UPennRocketry/flightcomputerv1/flightcomputerv1bomREPLY.xls

PCBWay Bom Quotation, Product No.:T-X6W971159A
Item # | *Designator | *Qty | Manufacturer | *Mfg Part # | Description / Value | *Package/Footprint | Mounting Type | Your Instructions / Notes | Assembly requirement | *Unit Price(1 set) | *Total | *Delivery Time | *PCBWay Note | Customer Reply | PCBWay Update
1 | BZ1 | 1 | PUI Audio | AT-0927-TT-6-R | Buzzer『 』Buzzer, polarized | MagneticBuzzer_PUI_AT-0927-TT-6-R『 』THT | tht |  |  | $0.677 | $0.677 | 7-10Workdays
2 | C1, C4, C5 | 3 | Samsung Electro-Mechanics | CL10B104KA8NNNC | 0.1uF『 』Unpolarized capacitor, <10% tolerance | C_0201_0603Metric_Pad0.64x0.40mm_HandSolder『 』0603 | smt | generic |  | $0.050 | $0.150 |  | The correct package for the listed Part Number [CL10B104KA8NNNC] is indeed [0603], not [0201].Please confirm. | Yes, 0603 package please
3 | C10, C3, C7, C8 | 4 | Samsung Electro-Mechanics | CL10A106KQ8NNNC | 10uF『 』Unpolarized capacitor, <10% tolerance | C_0201_0603Metric_Pad0.64x0.40mm_HandSolder『 』0603 | smt | generic |  | $0.050 | $0.200 |  | The correct package for the listed Part Number [CL10A106KQ8NNNC] is indeed [0603（1608 metric）], not [0201].Please confirm. | Yes, 0603 package please
4 | C2 | 1 | Samsung Electro-Mechanics | CL10B105KP8NNNC | 1uF『 』Unpolarized capacitor, <10% tolerance | C_0201_0603Metric_Pad0.64x0.40mm_HandSolder『 』0603 | smt | generic |  | $0.050 | $0.050 |  | The correct package for the listed Part Number [CL10B105KP8NNNC] is indeed [0603（1608 metric）], not [0201].Please confirm. | Yes, 0603 package please
5 | C6 | 1 | Samsung Electro-Mechanics | CL10B104KA8NNNC | 100nF『 』Unpolarized capacitor, <10% tolerance | C_0201_0603Metric_Pad0.64x0.40mm_HandSolder『 』0603 | smt | generic |  | $0.050 | $0.050 |  | The correct package for the listed Part Number [CL10B104KA8NNNC] is indeed [0603], not [0201].Please confirm. | Yes, 0603 package please
6 | C9 | 1 | Samsung Electro-Mechanics | CL10A226MP8NUNE | 22uF『 』Unpolarized capacitor, <10% tolerance | C_0201_0603Metric_Pad0.64x0.40mm_HandSolder『 』0603 | smt | generic |  | $0.050 | $0.050 |  | The correct package for the listed Part Number [CL10A226MP8NUNE] is indeed [0603（1608 metric）], not [0201].Please confirm. | Yes, 0603 package please
7 | D1 | 1 | Würth Elektronik | 150060RS75000 | LED『 』Light emitting diode, RED | LED_0603_1608Metric_Pad1.05x0.95mm_HandSolder『 』0603 | smt | generic |  | $0.374 | $0.374 | 7-10 Workdays
8 | D2 | 1 | Würth Elektronik | 150060YS75000 | LED『 』Light emitting diode, YELLOW | LED_0603_1608Metric_Pad1.05x0.95mm_HandSolder『 』0603 | smt | generic |  | $0.374 | $0.374 | 7-10 Workdays
9 | D3 | 1 | Würth Elektronik | 150060GS75000 | LED『 』Light emitting diode, GREEN | LED_0603_1608Metric_Pad1.05x0.95mm_HandSolder『 』0603 | smt | generic |  | $0.374 | $0.374 | 7-10 Workdays
10 | IC1 | 1 | MEMSIC | MMC5983MA | MMC5983MA『 』3-AXIS MAGNETIC SENSOR | MMC5983MA_MEM『 』16-VFLGA | smt |  |  | $2.013 | $2.013
11 | J1, J2 | 2 | TE Connectivity AMP Connectors | 282834-2 | Screw_Terminal_01x02『 』TERM BLK 2P SIDE ENT 2.54MM PCB | TerminalBlock_TE_282834-2_1x02_P2.54mm_Horizontal『 』THT | tht | Ensure screw terminals facing out of board |  | $1.238 | $2.476 | 7-10Workdays
12 | J10 | 1 |  |  | Conn_01x01『 』Generic connector, single row, 01x01, script generated (kicad-library-utils/schlib/autogen/connector/) | PinHeader_1x01_P2.54mm_Vertical『 』THT | tht |  | DNP |  |  |  | [DNP不要贴];
13 | J11 | 1 |  |  | Conn_01x01『 』Generic connector, single row, 01x01, script generated (kicad-library-utils/schlib/autogen/connector/) | PinHeader_1x01_P2.54mm_Vertical『 』THT | tht |  | DNP |  |  |  | [DNP不要贴];
14 | J3 | 1 |  |  | Conn_01x03『 』Generic connector, single row, 01x03, script generated (kicad-library-utils/schlib/autogen/connector/) | PinHeader_1x03_P2.54mm_Vertical『 』THT | tht |  | DNP |  |  |  | [DNP不要贴];
15 | J4 | 1 |  |  | Conn_01x03『 』Generic connector, single row, 01x03, script generated (kicad-library-utils/schlib/autogen/connector/) | PinHeader_1x03_P2.54mm_Vertical『 』THT | tht |  | DNP |  |  |  | [DNP不要贴];
16 | J5 | 1 | JST Sales America Inc. | S2B-PH-K-S | Conn_01x02『 』CONN HEADER R/A 2POS 2MM | JST_PH_S2B-PH-K_1x02_P2.00mm_Horizontal『 』THT | tht |  |  | $0.828 | $0.828 | 7-10 Workdays
17 | J6 | 1 |  |  | Conn_01x24『 』Generic connector, single row, 01x24, script generated (kicad-library-utils/schlib/autogen/connector/) | Molex_SL_171971-0024_1x24_P2.54mm_Vertical『 』THT | tht |  | DNP |  |  |  | [DNP不要贴];
18 | J7 | 1 |  |  | Conn_01x24『 』Generic connector, single row, 01x24, script generated (kicad-library-utils/schlib/autogen/connector/) | Molex_SL_171971-0024_1x24_P2.54mm_Vertical『 』THT | tht |  | DNP |  |  |  | [DNP不要贴];
19 | J8, J9 | 2 | Amphenol RF | 132134 | Conn_Coaxial『 』CONN SMA JACK STR 50 OHM PCB | SMA_Amphenol_132134-10_Vertical『 』SMA | smt |  |  | $4.541 | $9.082
20 | J12, J13 | 2 | Molex | 734120110 | Conn_Coaxial『 』U.FL (UMCC) Connector Receptacle, Male Pin 50 Ohms Surface Mount Solder | U.FL_Molex_MCRF_73412-0110_Vertical『 』U.FL | smt |  |  | $0.747 | $1.494
21 | M1, M2 | 2 | Harwin Inc. | M20-9990345 | Motor_Servo『 』Servo Motor (Futaba, HiTec, JR connector) | PinHeader_1x03_P2.54mm_Vertical『 』THT | tht |  |  | $0.634 | $1.268 | 7-10 Workdays
22 | Q1 | 1 | Vishay Siliconix | SI4925DDY-T1-GE3 | SI4925DDY-T1-GE3『 』Vishay SI4925DDY-T1-GE3 Dual P-channel MOSFET Transistor, 8 A, 30 V, 8-Pin SOIC | SOIC127P600X175-8N『 』8-SOIC (0.154, 3.90mm Width) | smt |  |  | $2.367 | $2.367
23 | Q2 | 1 | onsemi | MMBT3904LT3G | MMBT3904『 』0.2A Ic, 40V Vce, Small Signal NPN Transistor, SOT-23 | SOT-23『 』SOT-23-3 (TO-236) | smt |  |  | $0.664 | $0.664
24 | Q3 | 1 | onsemi | MMBT3904LT3G | MMBT3904『 』0.2A Ic, 40V Vce, Small Signal NPN Transistor, SOT-23 | SOT-23『 』SOT-23-3 (TO-236) | smt |  |  | $0.664 | $0.664
25 | R1, R3 | 2 | Panasonic Electronic Components | ERJ-3GEYJ103V | 10K『 』Resistor, <10% tolerance | R_0201_0603Metric_Pad0.64x0.40mm_HandSolder『 』0603 | smt | generic |  | $0.046 | $0.092 |  | The correct package for the listed Part Number [ERJ-3GEYJ103V] is indeed [0603], not [0201].Please confirm. | Yes, 0603 package please
26 | R10, R11, R9 | 3 | Panasonic Electronic Components | ERJ-3EKF1500V | 150『 』Resistor, <10% tolerance | R_0201_0603Metric_Pad0.64x0.40mm_HandSolder『 』0603 | smt | generic |  | $0.046 | $0.138 |  | The correct package for the listed Part Number [ERJ-3EKF1500V] is indeed [0603], not [0201].Please confirm. | Yes, 0603 package please
27 | R14 | 1 | Panasonic Electronic Components | ERA-3AEB122V | 1.2k『 』Resistor, <10% tolerance | R_0201_0603Metric_Pad0.64x0.40mm_HandSolder『 』0603 | smt | generic |  | $0.189 | $0.189 |  | The correct package for the listed Part Number [ERA3AEB122V] is indeed [0603], not [0201].Please confirm. | Yes, 0603 package please
28 | R15, R7, R8 | 3 | Panasonic Electronic Components | ERA-3AEB472V | 4.7k『 』Resistor, <10% tolerance | R_0201_0603Metric_Pad0.64x0.40mm_HandSolder『 』0603 | smt | generic |  | $0.189 | $0.567 |  | The correct package for the listed Part Number [ERA-3AEB472V] is indeed [0603], not [0201].Please confirm. | Yes, 0603 package please
29 | R2, R4 | 2 | Panasonic Electronic Components | ERJ-3EKF1001V | 1K『 』Resistor, <10% tolerance | R_0201_0603Metric_Pad0.64x0.40mm_HandSolder『 』0603 | smt | generic |  | $0.046 | $0.092 |  | The correct package for the listed Part Number [ERJ-3EKF1001V] is indeed [0603], not [0201].Please confirm. | Yes, 0603 package please
30 | S1 | 1 | Same Sky (Formerly CUI Devices) | TS04-66-70-BK-160-SMT | TS04-66-70-BK-160-SMT『 』SWITCH TACTILE SPST-NO 0.05A 12V | SW_TS04-66-70-BK-160-SMT『 』Gull Wing | smt | generic |  | $0.253 | $0.253 | 7-10 Workdays
31 | S2 | 1 | Same Sky (Formerly CUI Devices) | TS04-66-70-BK-160-SMT | TS04-66-70-BK-160-SMT『 』SWITCH TACTILE SPST-NO 0.05A 12V | SW_TS04-66-70-BK-160-SMT『 』Gull Wing | smt |  |  | $0.253 | $0.253 | 7-10 Workdays
32 | TP1, TP4, TP5, TP6, TP7 | 5 |  |  | TestPoint『 』test point | TestPoint_Pad_1.0x1.0mm『 』THT | tht |  |  |  |  |  | DNP?[DNP不要贴];
33 | TP2, TP3 | 2 |  |  | TestPoint『 』test point | PinHeader_1x01_P2.54mm_Vertical『 』THT | tht |  | DNP |  |  |  | [DNP不要贴];
34 | U1 | 1 |  |  | Teensy4.1 | Teensy41 | tht | Will solder myself | DNP |  |  |  | [DNP不要贴];
35 | U2 | 1 | TE Connectivity Measurement Specialties | MS560702BA03-50 | MS5607-02BA『 』Barometric pressure sensor, 20cm resolution, 10 to 1200 mbar, I2C and SPI interface up to 20MHz, LGA-8 | LGA-8_3x5mm_P1.25mm『 』8-SMD | smt |  |  | $3.019 | $3.019
36 | U3 | 1 | Bosch Sensortec | BMI088 | BMI088『 』Accelerometer, Gyroscope, 6 Axis Sensor I²C, SPI Output | PQFN50P450X300X100-16N『 』16-VFLGA Module | smt |  |  | $2.717 | $2.717
37 | U4 | 1 | Microchip Technology | MIC29302AWD-TR | MIC29302AWD『 』3A low dropout linear regulator, shutdown pin, 3V to 16V input voltage, 1.24V to 15V adjustable output, TO-252 | TO-252-5_TabPin3『 』TO-252-6, DPAK (5 Leads + Tab) | smt |  |  | $1.226 | $1.226
38 | U5 | 1 | u-blox | MAX-M10S-00B | MAX-M10S『 』GNSS Module MAX M10, VCC 1.65V to 3.6V | ublox_MAX『 』18-SMD Module | smt |  |  | $28.885 | $28.885 | 7-10 Workdays
39 | U6 | 1 | RF Solutions | RFM95W-915S2 | RFM95W-915S2『 』Low power long range transceiver module, SPI and parallel interface, 915 MHz, spreading factor 6 to12, bandwidth 7.8 to 500kHz, -111 to -148 dBm, SMD-16, DIP-16 | HOPERF_RFM9XW_SMD『 』16-SMD Module | smt |  |  | $8.855 | $8.855
40 | U7 | 1 | STMicroelectronics | LD1117S50TR | LD1117S50TR_SOT223『 』800mA Fixed Low Drop Positive Voltage Regulator, Fixed Output 5.0V, SOT-223 | SOT-223-3_TabPin2『 』TO-261-4, TO-261AA | smt |  |  | $0.099 | $0.099
 |  |  |  |  |  |  |  |  |  | Component Cost | $69.54
 |  |  |  |  |  |  |  |  |  | Assembly Cost
 |  |  |  |  |  |  |  |  |  | PCB Cost
 |  |  |  |  |  |  |  |  |  | V0 Member 0% off | $0.00
 |  |  |  |  |  |  |  |  |  | All Total 1 Sets | $69.54
