UPennRocketry/flightcomputerv1/RocketryLibrary/3Dmodels/L80RE-M37.step

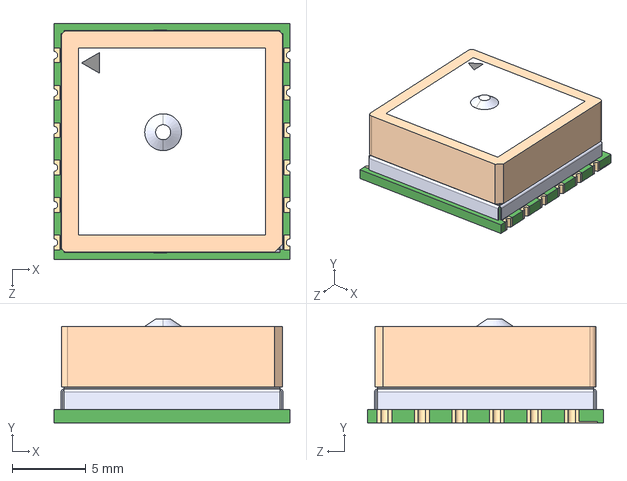
[picture p1: CAD file, 2025-04-29]
RocketryLibrary/3Dmodels/L80RE-M37.step
16.0 x 7.05 x 16.0 mm
