UPennRocketry/flightcomputerv1/RocketryLibrary/3Dmodels/TO-252-5_MCH.step

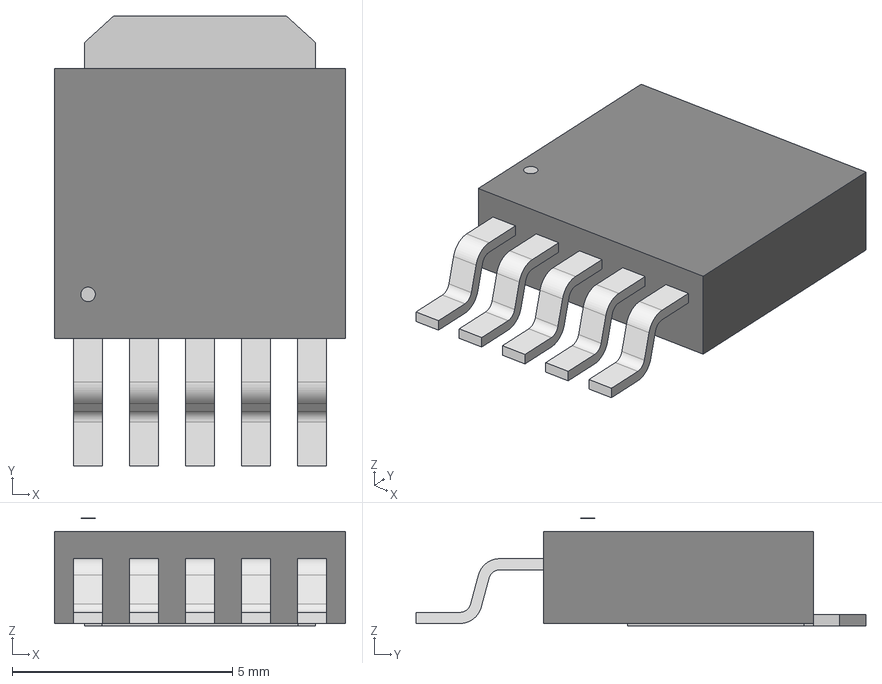
[picture p2: CAD file, 2025-04-29]
RocketryLibrary/3Dmodels/TO-252-5_MCH.step
6.60 x 10.2 x 2.44 mm
