UPennRocketry/flightcomputerv1/RocketryLibrary/3Dmodels/KMR221GLFS.step

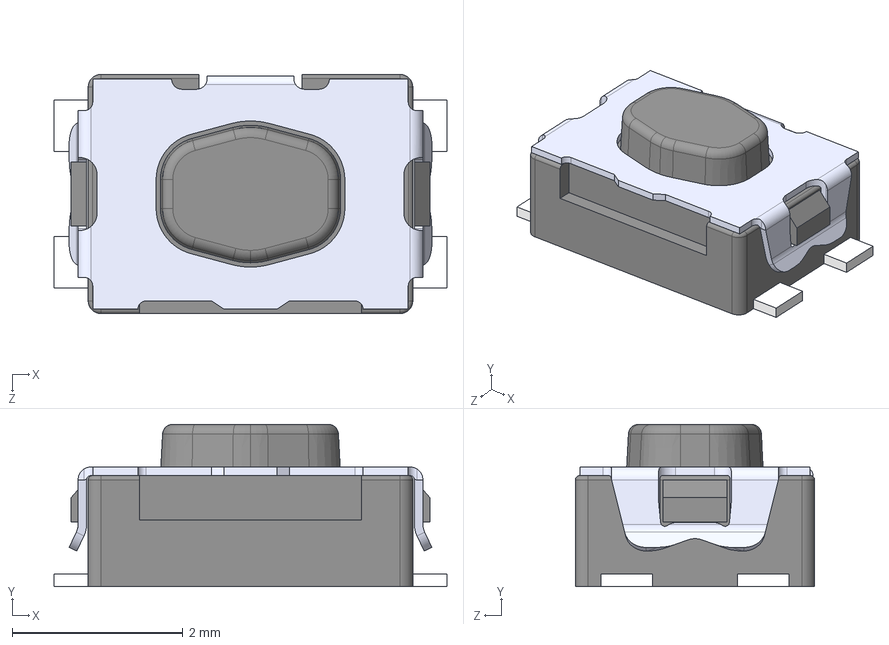
[picture p3: CAD file, 2025-04-29]
RocketryLibrary/3Dmodels/KMR221GLFS.step
4.60 x 1.90 x 2.80 mm
