UPennRocketry/flightcomputerv1/RocketryLibrary/3Dmodels/LIS2MDLTR.step

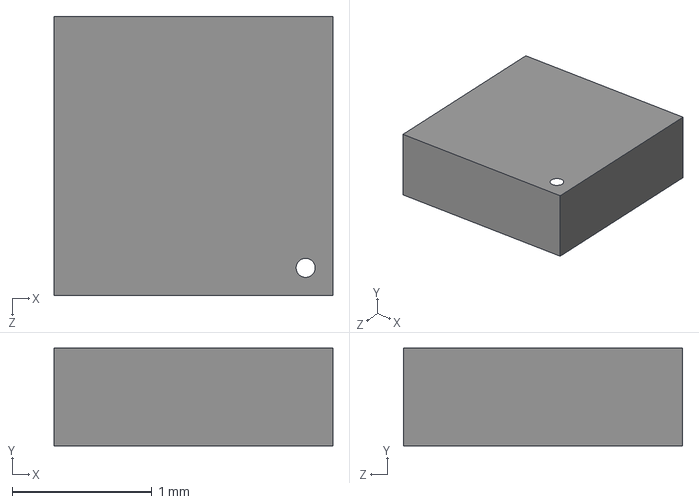
[picture p4: CAD file, 2025-04-29]
RocketryLibrary/3Dmodels/LIS2MDLTR.step
2.00 x 0.7 x 2.00 mm
