UPennRocketry/flightcomputerv1/RocketryLibrary/3Dmodels/MMC5983MA_MEM.step

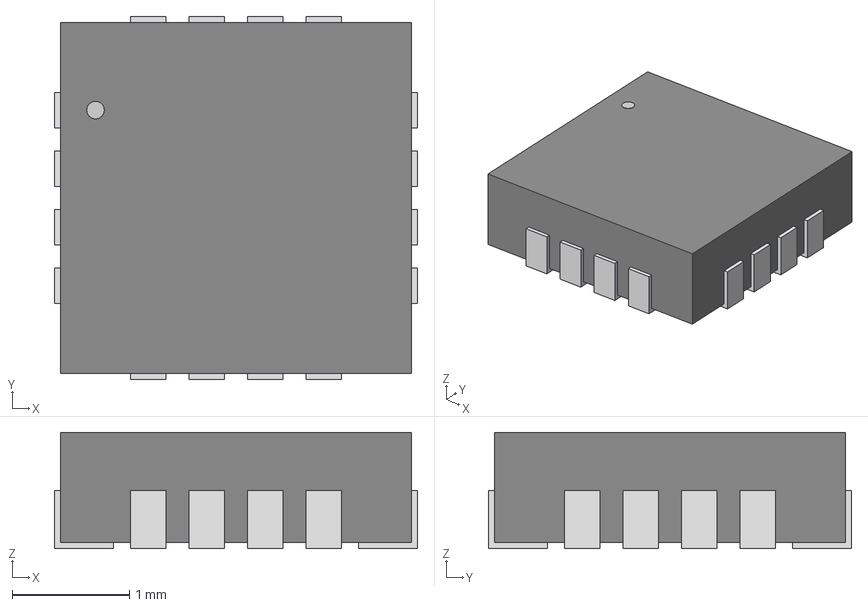
[picture p5: CAD file, 2025-03-11]
RocketryLibrary/3Dmodels/MMC5983MA_MEM.step
3.10 x 3.10 x 0.993 mm
