UPennRocketry/flightcomputerv1/RocketryLibrary/3Dmodels/TS04-66-70-BK-160-SMT.step

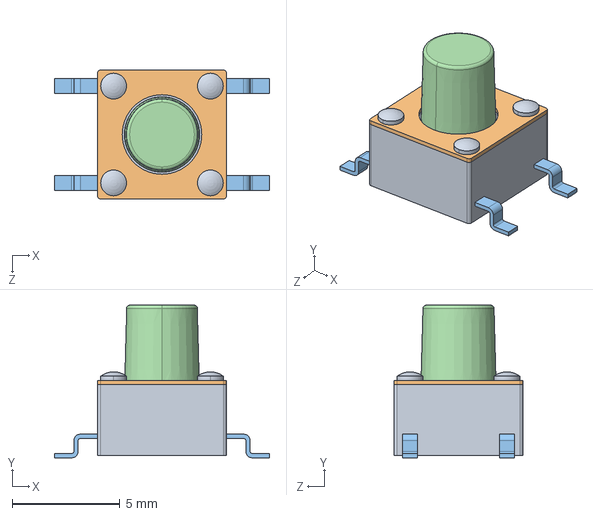
[picture p6: CAD file, 2025-02-16]
RocketryLibrary/3Dmodels/TS04-66-70-BK-160-SMT.step
10.0 x 7.10 x 6.00 mm
