UPennRocketry/flightcomputerv1/RocketryLibrary/3Dmodels/SLW-913535_CUD.step

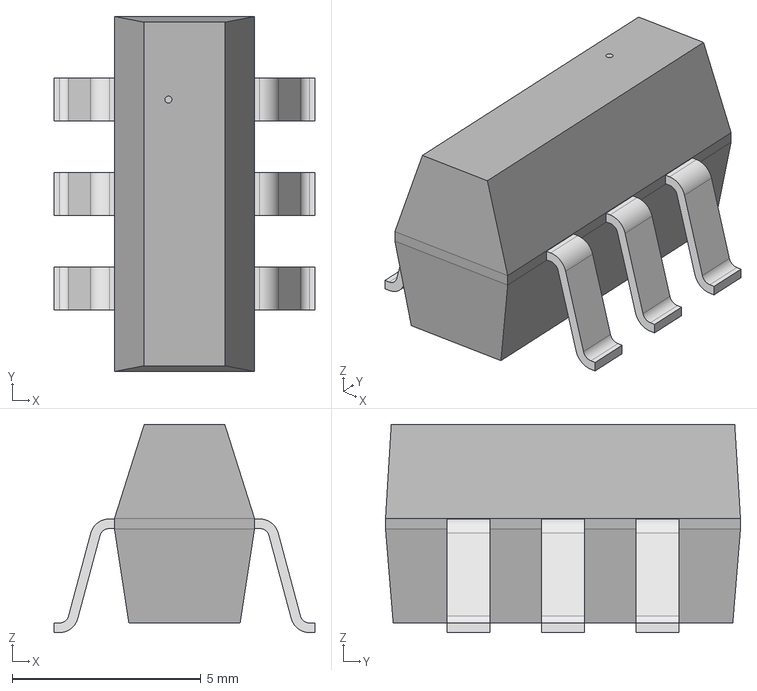
[picture p7: CAD file, 2025-01-15]
RocketryLibrary/3Dmodels/SLW-913535_CUD.step
6.91 x 9.40 x 5.51 mm
