UPennRocketry/flightcomputerv1/RocketryLibrary/3Dmodels/W25Q64JVSSIQ.step

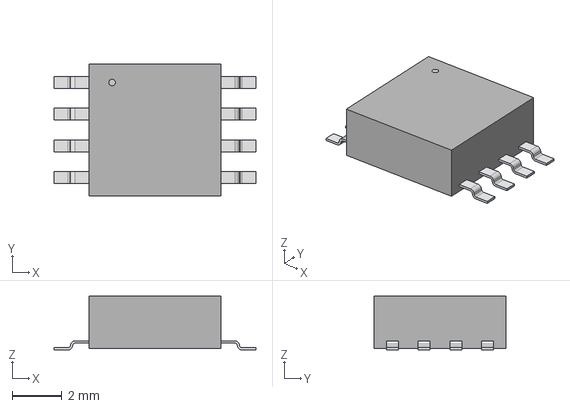
[picture p8: CAD file, 2024-12-10]
RocketryLibrary/3Dmodels/W25Q64JVSSIQ.step
8.10 x 5.28 x 2.16 mm
