UPennRocketry/flightcomputerv1/RocketryLibrary/3Dmodels/ADXL375BCCZ_RL.step

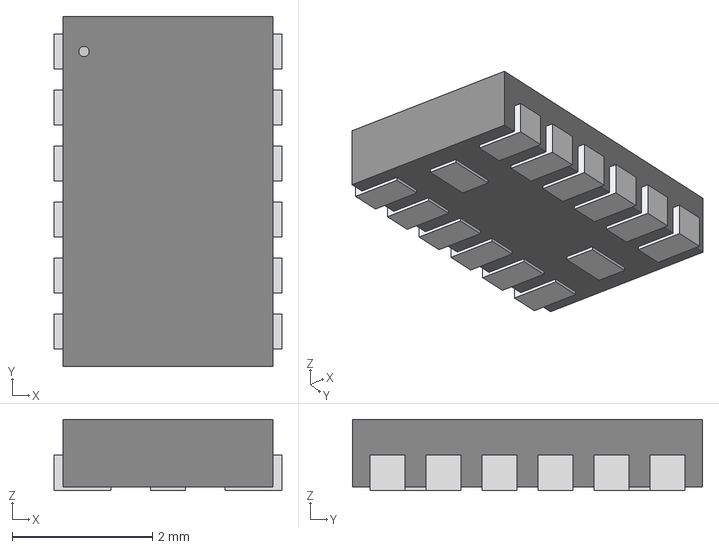
[picture p9: CAD file, 2024-12-10]
RocketryLibrary/3Dmodels/ADXL375BCCZ_RL.step
3.25 x 5.00 x 1.02 mm
