UPennRocketry/flightcomputerv1/RocketryLibrary/3Dmodels/SI4925DDY-T1-GE3.stp

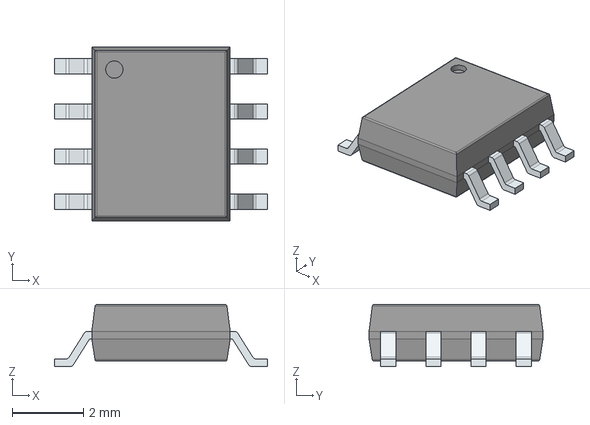
[picture p10: CAD file, 2024-12-10]
RocketryLibrary/3Dmodels/SI4925DDY-T1-GE3.stp
6.00 x 4.90 x 1.75 mm
PinsArrayLR
