UPennRocketry/flightcomputerv1/RocketryLibrary/3Dmodels/MCP130T_300I_TT.step

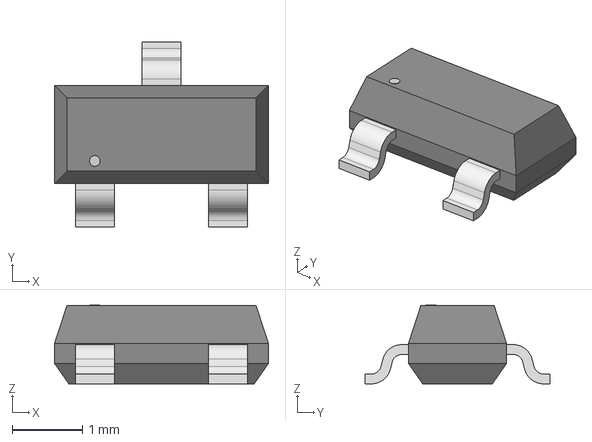
[picture p11: CAD file, 2024-12-10]
RocketryLibrary/3Dmodels/MCP130T_300I_TT.step
3.05 x 2.64 x 1.12 mm
