UPennRocketry/flightcomputerv1/RocketryLibrary/3Dmodels/BMI088.step

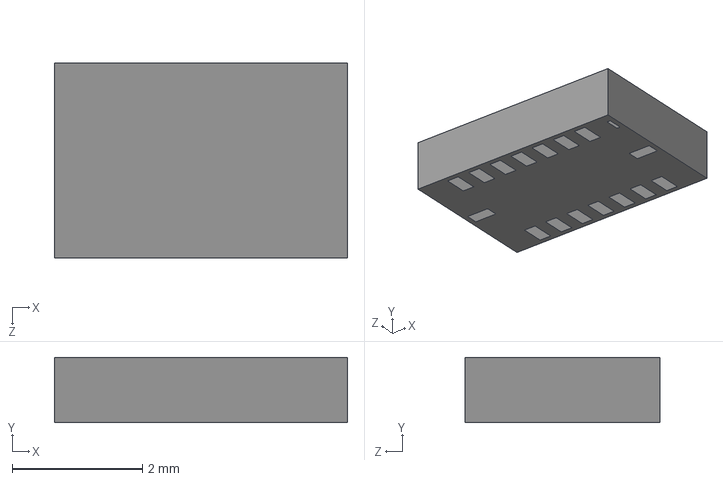
[picture p12: CAD file, 2024-12-10]
RocketryLibrary/3Dmodels/BMI088.step
4.50 x 1.00 x 3.00 mm
