UPennRocketry/flightcomputerv1/RocketryLibrary/3Dmodels/282837-2.step

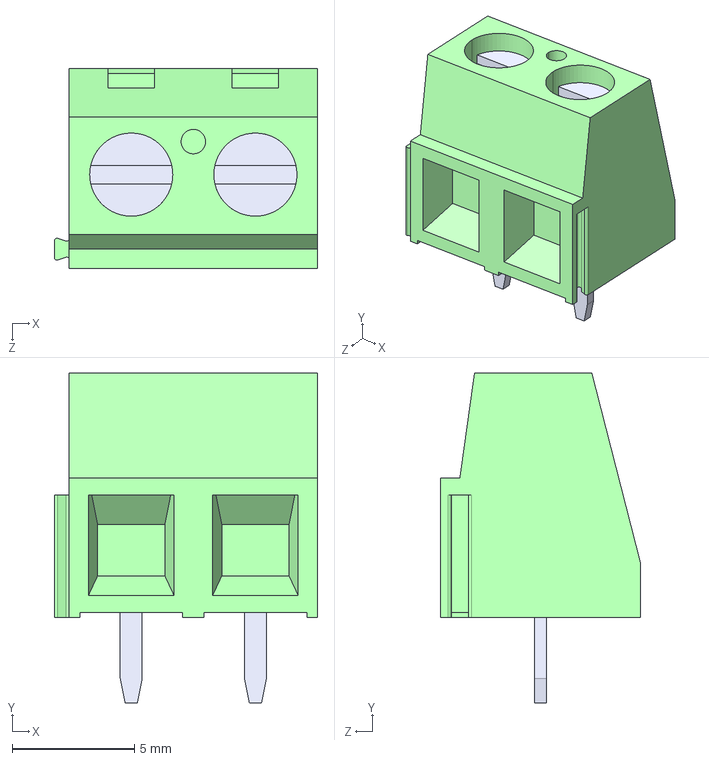
[picture p13: CAD file, 2025-04-29]
RocketryLibrary/3Dmodels/282837-2.step
10.8 x 13.5 x 8.20 mm
