UPennRocketry/flightcomputerv1/flightcomputerv1.kicad_pcb

## KiCad design flightcomputerv1.kicad_pcb (2025-04-29)

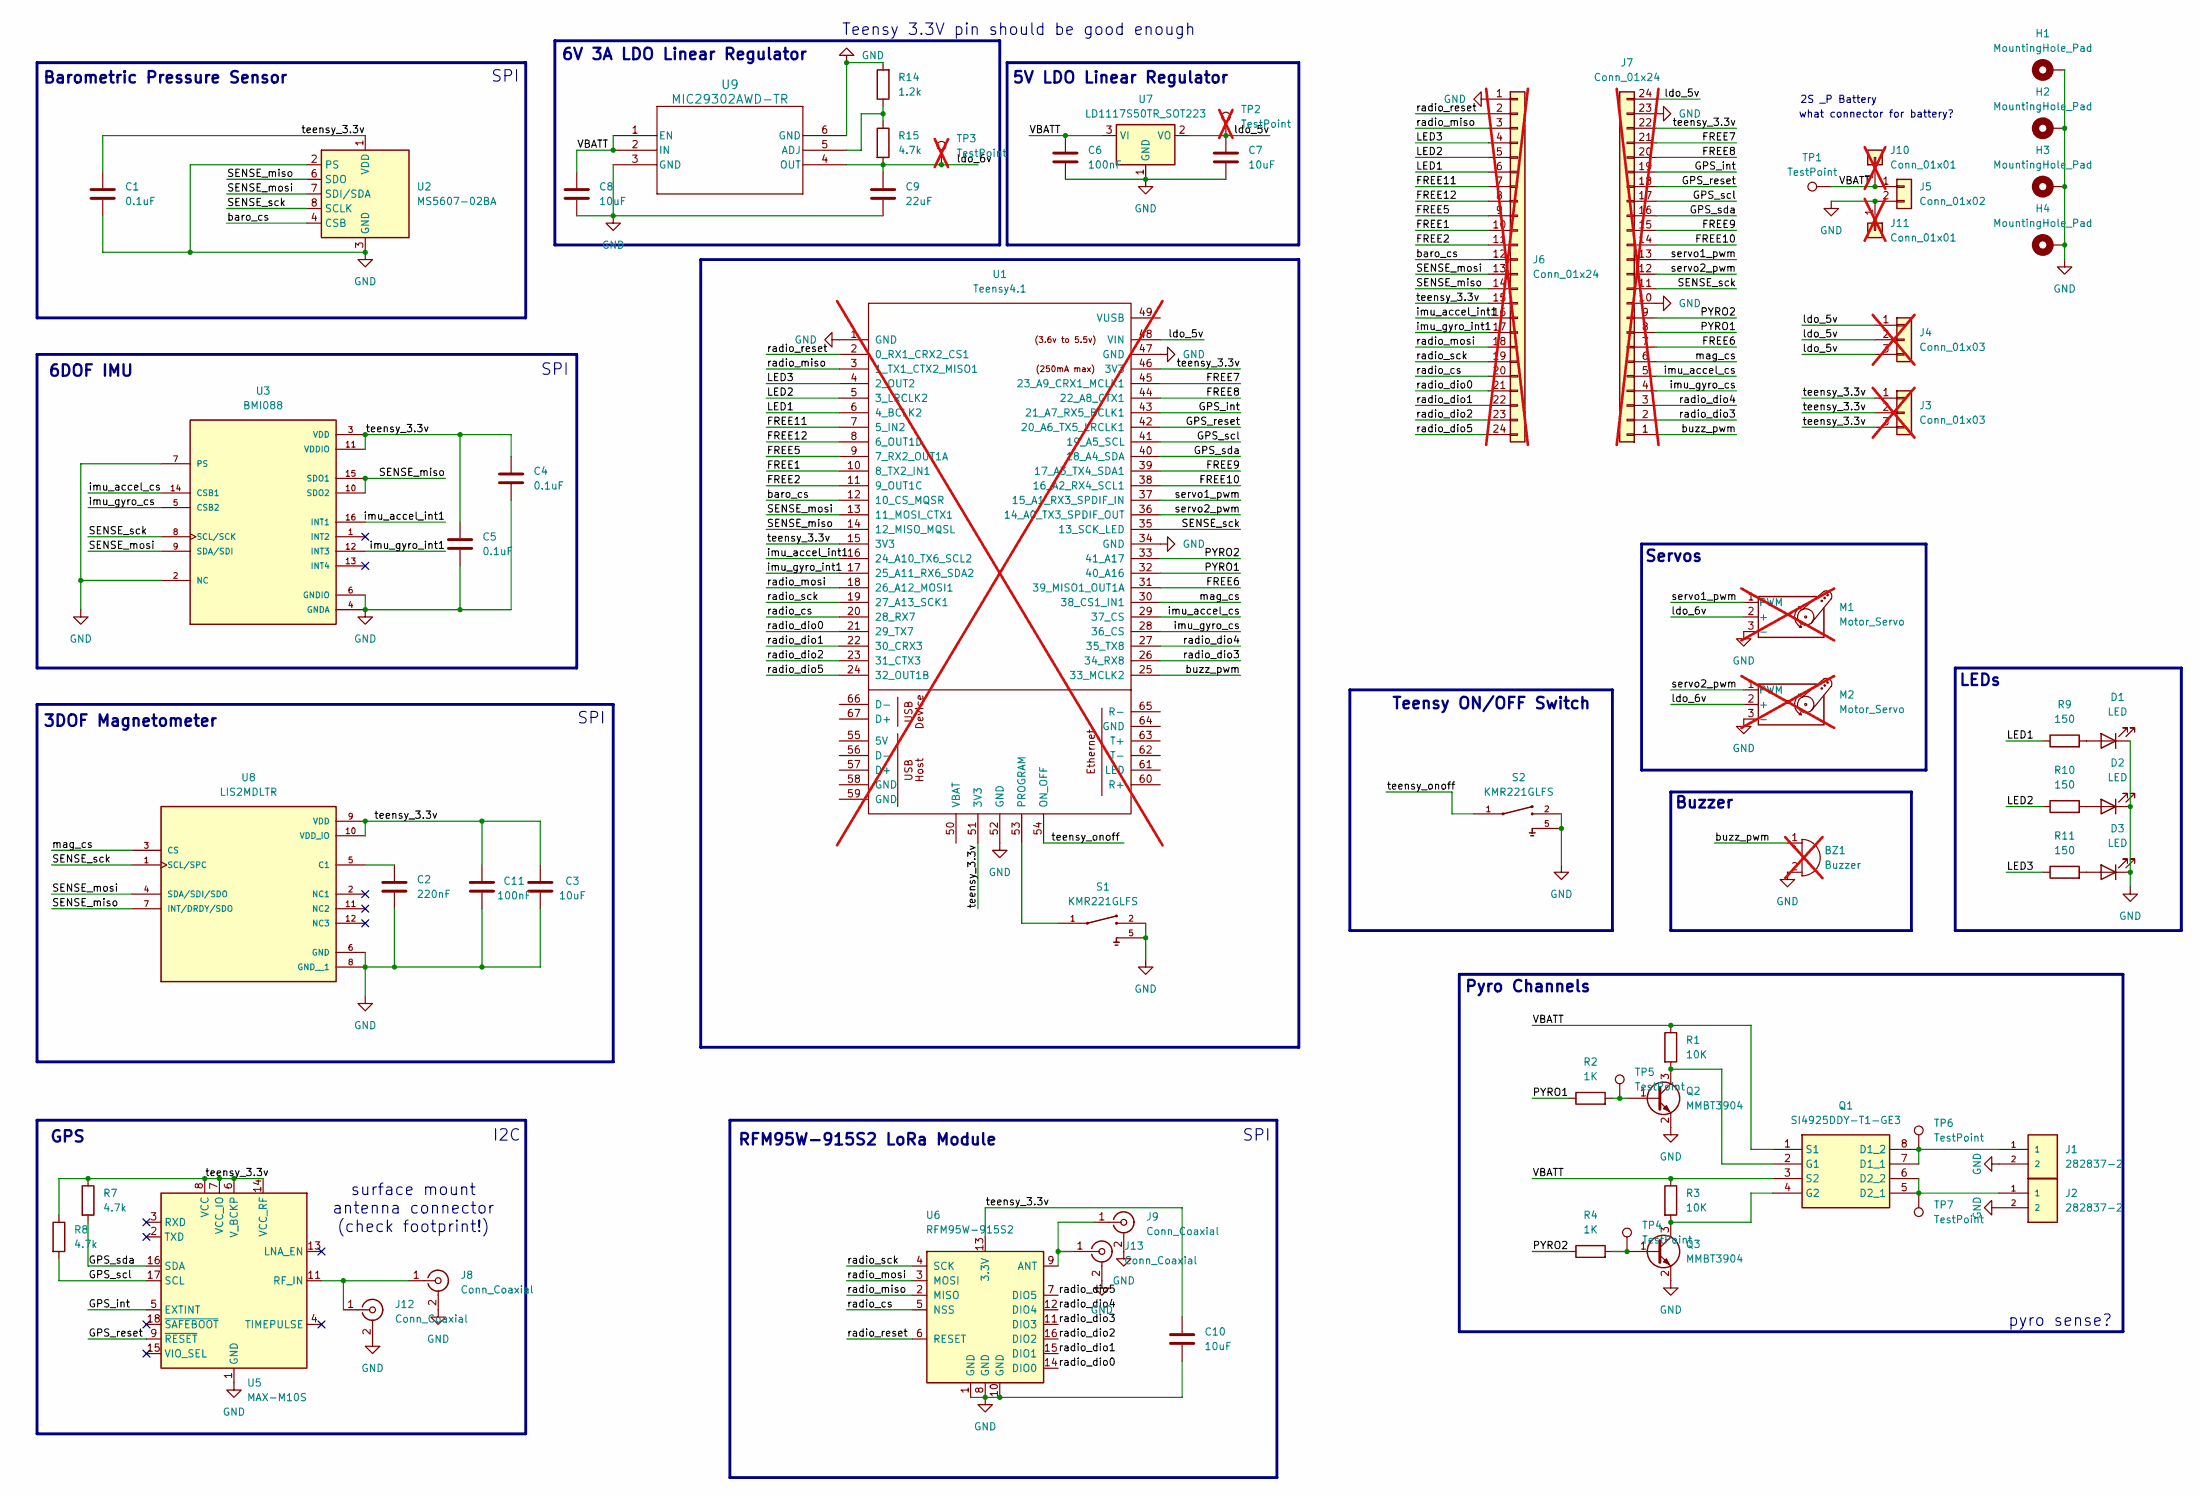
[picture p14: schematic flightcomputerv1.kicad_sch]

Parts:
BZ1: Buzzer; MagneticBuzzer_PUI_AT-0927-TT-6-R; MPN AT-0927-TT-6-R; not fitted
C1, C4, C5: 0.1uF; C_0402_1005Metric_Pad0.74x0.62mm_HandSolder
C2: 220nF; C_0402_1005Metric_Pad0.74x0.62mm_HandSolder
C3: 10uF; C_0402_1005Metric_Pad0.74x0.62mm_HandSolder
C6: 100nF; C_0603_1608Metric_Pad1.08x0.95mm_HandSolder
C7, C8, C10: 10uF; C_0603_1608Metric_Pad1.08x0.95mm_HandSolder
C9: 22uF; C_0603_1608Metric_Pad1.08x0.95mm_HandSolder
C11: 100nF; C_0402_1005Metric_Pad0.74x0.62mm_HandSolder
D1, D2, D3: LED; LED_0603_1608Metric_Pad1.05x0.95mm_HandSolder
H1, H2, H3, H4: MountingHole_Pad; MountingHole_2.2mm_M2_DIN965_Pad
J1, J2: 282837-2; TE_282837-2; PARTREV G3
J3, J4: Conn_01x03; PinHeader_1x03_P2.54mm_Vertical; not fitted
J5: Conn_01x02; JST_PH_S2B-PH-K_1x02_P2.00mm_Horizontal
J6, J7: Conn_01x24; Molex_SL_171971-0024_1x24_P2.54mm_Vertical; not fitted
J8, J9: Conn_Coaxial; SMA_Amphenol_132134-10_Vertical; MPN 132134
J10, J11: Conn_01x01; PinHeader_1x01_P2.54mm_Vertical; not fitted
J12, J13: Conn_Coaxial; U.FL_Hirose_U.FL-R-SMT-1_Vertical
M1, M2: Motor_Servo; PinHeader_1x03_P2.54mm_Vertical; not fitted
Q1: SI4925DDY-T1-GE3; SOIC127P600X175-8N; MPN SI4925DDY-T1-GE3
Q2: MMBT3904; SOT-23; MPN MMBT3904LT3G
Q3: MMBT3904; SOT-23
R1, R3: 10K; R_0603_1608Metric_Pad0.98x0.95mm_HandSolder
R2, R4: 1K; R_0603_1608Metric_Pad0.98x0.95mm_HandSolder
R7, R8, R15: 4.7k; R_0603_1608Metric_Pad0.98x0.95mm_HandSolder
R9, R10, R11: 150; R_0603_1608Metric_Pad0.98x0.95mm_HandSolder
R14: 1.2k; R_0603_1608Metric_Pad0.98x0.95mm_HandSolder
S1, S2: KMR221GLFS; SW_KMR221GLFS
TP1, TP4, TP5, TP6, TP7: TestPoint; TestPoint_Pad_1.0x1.0mm
TP2, TP3: TestPoint; PinHeader_1x01_P2.54mm_Vertical; not fitted
U1: Teensy4.1; Teensy41; not fitted
U2: MS5607-02BA; LGA-8_3x5mm_P1.25mm; MPN MS560702BA03-50
U3: BMI088; PQFN50P450X300X100-16N; MPN BMI088
U5: MAX-M10S; ublox_MAX; MPN MAX-M10S-00B
U6: RFM95W-915S2; HOPERF_RFM9XW_SMD; MPN RFM95W-915S2
U7: LD1117S50TR_SOT223; SOT-223-3_TabPin2; MPN LD1117S50TR
U8: LIS2MDLTR; PQFN50P200X200X70-12N; PARTREV Rev 5
U9: MIC29302AWD-TR; TO-252-5_MCH

Connections:
/FREE1: J6.10, U1.10 (8_TX2_IN1)
/FREE2: J6.11, U1.11 (9_OUT1C)
/FREE5: J6.9, U1.9 (7_RX2_OUT1A)
/FREE6: J7.7, U1.31 (39_MISO1_OUT1A)
/FREE7: J7.21, U1.45 (23_A9_CRX1_MCLK1)
/FREE8: J7.20, U1.44 (22_A8_CTX1)
/FREE9: J7.15, U1.39 (17_A3_TX4_SDA1)
/FREE10: J7.14, U1.38 (16_A2_RX4_SCL1)
/FREE11: J6.7, U1.7 (5_IN2)
/FREE12: J6.8, U1.8 (6_OUT1D)
/GPS_int: J7.19, U1.43 (21_A7_RX5_BCLK1), U5.5 (EXTINT)
/GPS_reset: J7.18, U1.42 (20_A6_TX5_LRCLK1), U5.9 (~RESET)
/GPS_scl: J7.17, R8.2, U1.41 (19_A5_SCL), U5.17 (SCL)
/GPS_sda: J7.16, R7.2, U1.40 (18_A4_SDA), U5.16 (SDA)
/LED1: J6.6, R9.1, U1.6 (4_BCLK2)
/LED2: J6.5, R10.1, U1.5 (3_LRCLK2)
/LED3: J6.4, R11.1, U1.4 (2_OUT2)
/PYRO1: J7.8, R2.1, U1.32 (40_A16)
/PYRO2: J7.9, R4.1, U1.33 (41_A17)
/SENSE_miso: J6.14, U1.14 (12_MISO_MQSL), U2.6 (SDO), U3.10 (SDO2), U3.15 (SDO1), U8.7 (INT/DRDY/SDO)
/SENSE_mosi: J6.13, U1.13 (11_MOSI_CTX1), U2.7 (SDI/SDA), U3.9 (SDA/SDI), U8.4 (SDA/SDI/SDO)
/SENSE_sck: J7.11, U1.35 (13_SCK_LED), U2.8 (SCLK), U3.8 (SCL/SCK), U8.1 (SCL/SPC)
/VBATT: C6.1, C8.1, J5.1, J10.1, Q1.1 (S1), Q1.3 (S2), R1.1, R3.1, TP1.1, U7.3 (VI), U9.1 (EN), U9.2 (IN)
/baro_cs: J6.12, U1.12 (10_CS_MQSR), U2.4 (CSB), U2.5 (CSB)
/buzz_pwm: BZ1.1 (+), J7.1, U1.25 (33_MCLK2)
/imu_accel_cs: J7.5, U1.29 (37_CS), U3.14 (CSB1)
/imu_accel_int1: J6.16, U1.16 (24_A10_TX6_SCL2), U3.16 (INT1)
/imu_gyro_cs: J7.4, U1.28 (36_CS), U3.5 (CSB2)
/imu_gyro_int1: J6.17, U1.17 (25_A11_RX6_SDA2), U3.12 (INT3)
/ldo_5v: C7.1, J4.1, J4.2, J4.3, J7.24, TP2.1, U1.48 (VIN), U7.2 (VO)
/ldo_6v: C9.1, M1.2 (+), M2.2 (+), R15.2, TP3.1, U9.4 (OUT)
/mag_cs: J7.6, U1.30 (38_CS1_IN1), U8.3 (CS)
/radio_cs: J6.20, U1.20 (28_RX7), U6.5 (NSS)
/radio_dio0: J6.21, U1.21 (29_TX7), U6.14 (DIO0)
/radio_dio1: J6.22, U1.22 (30_CRX3), U6.15 (DIO1)
/radio_dio2: J6.23, U1.23 (31_CTX3), U6.16 (DIO2)
/radio_dio3: J7.2, U1.26 (34_RX8), U6.11 (DIO3)
/radio_dio4: J7.3, U1.27 (35_TX8), U6.12 (DIO4)
/radio_dio5: J6.24, U1.24 (32_OUT1B), U6.7 (DIO5)
/radio_miso: J6.3, U1.3 (1_TX1_CTX2_MISO1), U6.2 (MISO)
/radio_mosi: J6.18, U1.18 (26_A12_MOSI1), U6.3 (MOSI)
/radio_reset: J6.2, U1.2 (0_RX1_CRX2_CS1), U6.6 (RESET)
/radio_sck: J6.19, U1.19 (27_A13_SCK1), U6.4 (SCK)
/servo1_pwm: J7.13, M1.1 (PWM), U1.37 (15_A1_RX3_SPDIF_IN)
/servo2_pwm: J7.12, M2.1 (PWM), U1.36 (14_A0_TX3_SPDIF_OUT)
/teensy_3.3v: C1.1, C3.1, C4.1, C5.1, C10.1, C11.1, J3.1, J3.2, J3.3, J6.15, J7.22, R7.1, R8.1, U1.15 (3V3), U1.46 (3V3), U1.51 (3V3), U2.1 (VDD), U3.3 (VDD), U3.11 (VDDIO), U5.6 (V_BCKP), U5.7 (VCC_IO), U5.8 (VCC), U5.14 (VCC_RF), U6.13 (3.3V), U8.9 (VDD), U8.10 (VDD_IO)
/teensy_onoff: S2.1, U1.54 (ON_OFF)
GND: BZ1.2 (-), C1.2, C2.2, C3.2, C4.2, C5.2, C6.2, C7.2, C8.2, C9.2, C10.2, C11.2, D1.1 (K), D2.1 (K), D3.1 (K), H1.1, H2.1, H3.1, H4.1, J1.2, J2.2, J5.2, J6.1, J7.10, J7.23, J8.2 (Ext), J9.2 (Ext), J11.1, J12.2 (Ext), J13.2 (Ext), M1.3 (-), M2.3 (-), Q2.2 (E), Q3.2 (E), R14.2, S1.2, S1.5, S2.2, S2.5, U1.1 (GND), U1.34 (GND), U1.47 (GND), U1.52 (GND), U2.2 (PS), U2.3 (GND), U3.2 (NC), U3.4 (GNDA), U3.6 (GNDIO), U3.7 (PS), U5.1 (GND), U5.10 (GND), U5.12 (GND), U6.1 (GND), U6.8 (GND), U6.10 (GND), U7.1 (GND), U8.6 (GND), U8.8 (GND__1), U9.3 (GND), U9.6 (GND)
unnamed: D1.2 (A), R9.2
unnamed: D2.2 (A), R10.2
unnamed: D3.2 (A), R11.2
unnamed: J8.1 (In), J12.1 (In), U5.11 (RF_IN)
unnamed: J9.1 (In), J13.1 (In), U6.9 (ANT)
unnamed: J1.1, Q1.7 (D1_1), Q1.8 (D1_2), TP6.1
unnamed: J2.1, Q1.5 (D2_1), Q1.6 (D2_2), TP7.1
unnamed: Q1.2 (G1), Q2.3 (C), R1.2
unnamed: Q1.4 (G2), Q3.3 (C), R3.2
unnamed: Q2.1 (B), R2.2, TP5.1
unnamed: Q3.1 (B), R4.2, TP4.1
unnamed: S1.1, U1.53 (PROGRAM)
unnamed: C2.1, U8.5 (C1)
unnamed: R14.1, R15.1, U9.5 (ADJ)

Notes on the sheet:
SPI
5V LDO Linear Regulator
LEDs
GPS
Barometric Pressure Sensor
surface mount antenna connector (check footprint!)
pyro sense?
2S _P Battery
Teensy 3.3V pin should be good enough
3DOF Magnetometer
6DOF IMU
Servos
Teensy ON/OFF Switch
Buzzer
RFM95W-915S2 LoRa Module
what connector for battery?
Pyro Channels
I2C
6V 3A LDO Linear Regulator

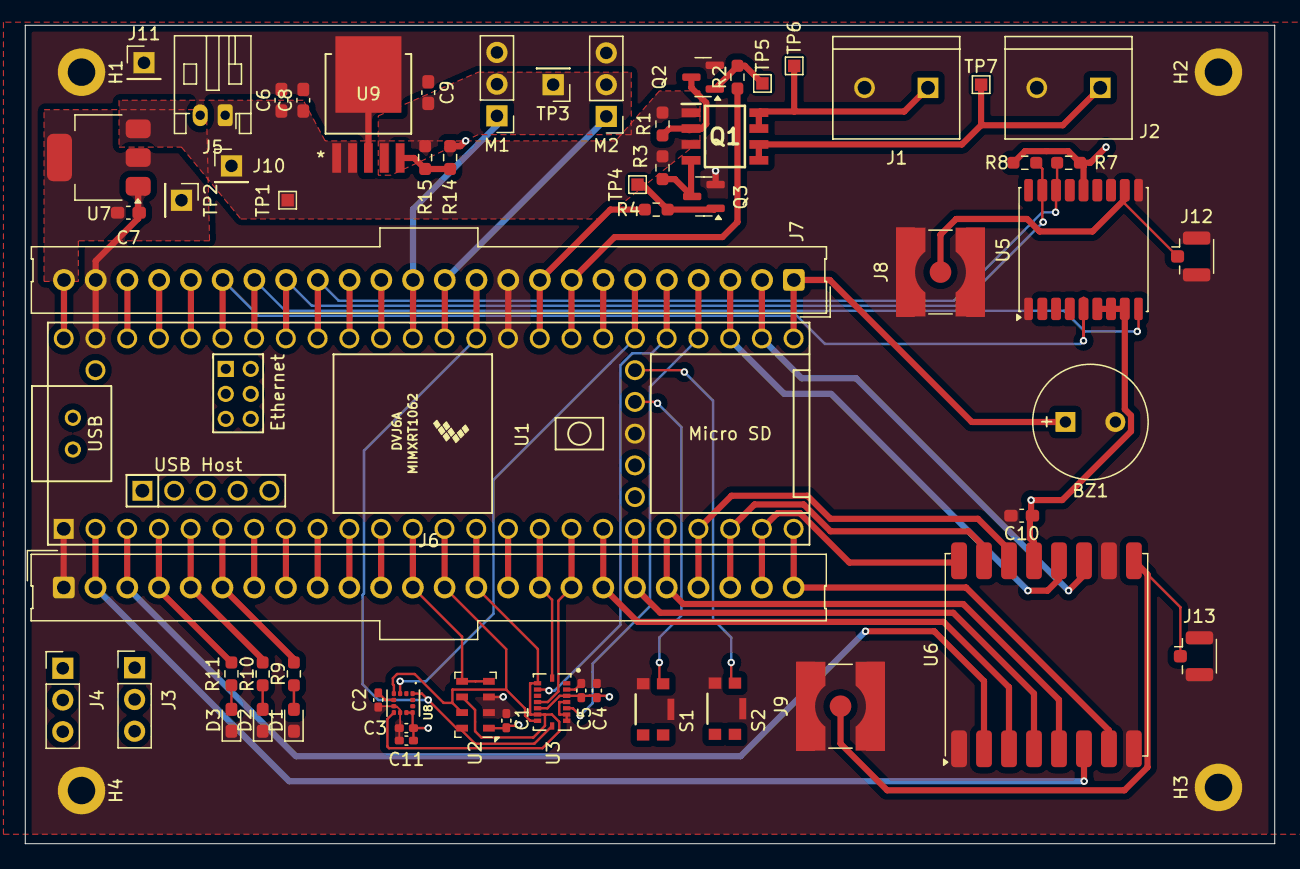
[picture p15: board flightcomputerv1.kicad_pcb from above]

Board: 4 copper layers, 100.0 x 65.5 mm, 65 parts (0 on the bottom side), 62 nets.
