UPennRocketry/flightcomputerv1/(commit log)

2024-12-10 first flight computer commit
    [ADXL375BCCZ_RL.step, BMI088.step, MCP130T_300I_TT.step, MMC5983MA.step, SI4925DDY-T1-GE3.stp, W25Q64JVSSIQ.step, flightcomputerv1.kicad_pcb, flightcomputerv1.kicad_sch]
2025-01-15 small update
    [SLW-913535_CUD.step, flightcomputerv1.kicad_sch]
2025-01-26 added radio module, still need footprint for either xbee or adafruit rfm95 breakout
    [flightcomputerv1.kicad_sch]
2025-02-02 started placement
    [flightcomputerv1.kicad_pcb, flightcomputerv1.kicad_sch]
2025-02-07 started placement (repush)
    [flightcomputerv1.kicad_pcb]
2025-02-09 updated pcb + backups
    [flightcomputerv1.kicad_pcb]
2025-02-09 updated pcb
    routing more but they're kinda sus
    [flightcomputerv1.kicad_pcb]
2025-02-09 signal traces can via through the board
    [flightcomputerv1.kicad_pcb]
2025-02-16 updated placement and routing 2/16
    [TS04-66-70-BK-160-SMT.step, flightcomputerv1.kicad_pcb, flightcomputerv1.kicad_sch]
2025-03-01 finished most of routing 2/28
    [flightcomputerv1.kicad_pcb]
2025-03-02 prelim routing placement done 3/2 need to check batt connector footprints + antenna connector + backup radio
    [flightcomputerv1.kicad_pcb, flightcomputerv1.kicad_sch]
2025-03-10 moved buttons
    [flightcomputerv1.kicad_pcb, flightcomputerv1.kicad_sch]
2025-03-11 magnetometer had wrong footprint. fixed all DRC errors. need to remake gerber
    [MMC5983MA.step, MMC5983MA_MEM.step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]
2025-03-20 still need to fill out BOM doc and get quote for assembly
    [Sample-BOM_JLCSMT.xlsx, Sample_BOM_PCBWay.xlsx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]
2025-04-29 2025 FINAL
    [282837-2.step, KMR221GLFS.step, L80RE-M37.step, LIS2MDLTR.step, TO-252-5_MCH.step, bom.csv, designators.csv, flightcomputerv1.kicad_pcb]
